bluetiger9/ScanMeBadge/README.md

# ScanMeBadge

KiCad - KiCad project

InkScape - Inkscape drawing

ScanMeBadge - Arduino example sketch

### Licence

Design files: CC-by-4.0

Example code: MIT
