bluetiger9/ScanMeBadge/KiCad/g3840.png

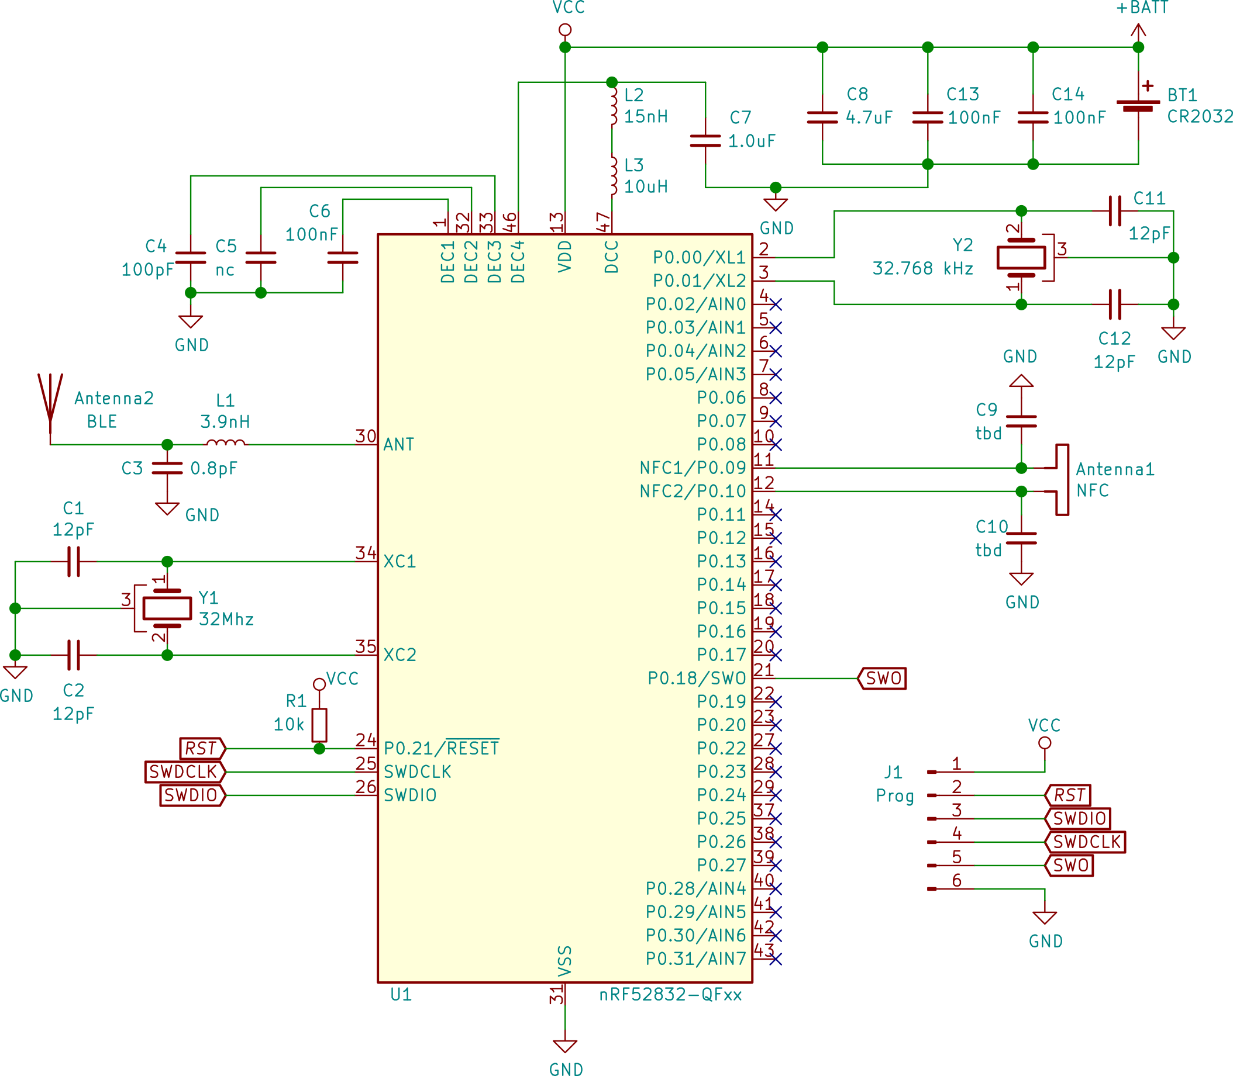
KiCad/g3840.png
