bluetiger9/ScanMeBadge/KiCad/BLE-NFC-Badge.kicad_pcb

## KiCad design KiCad/BLE-NFC-Badge.kicad_pcb (2019-03-12)

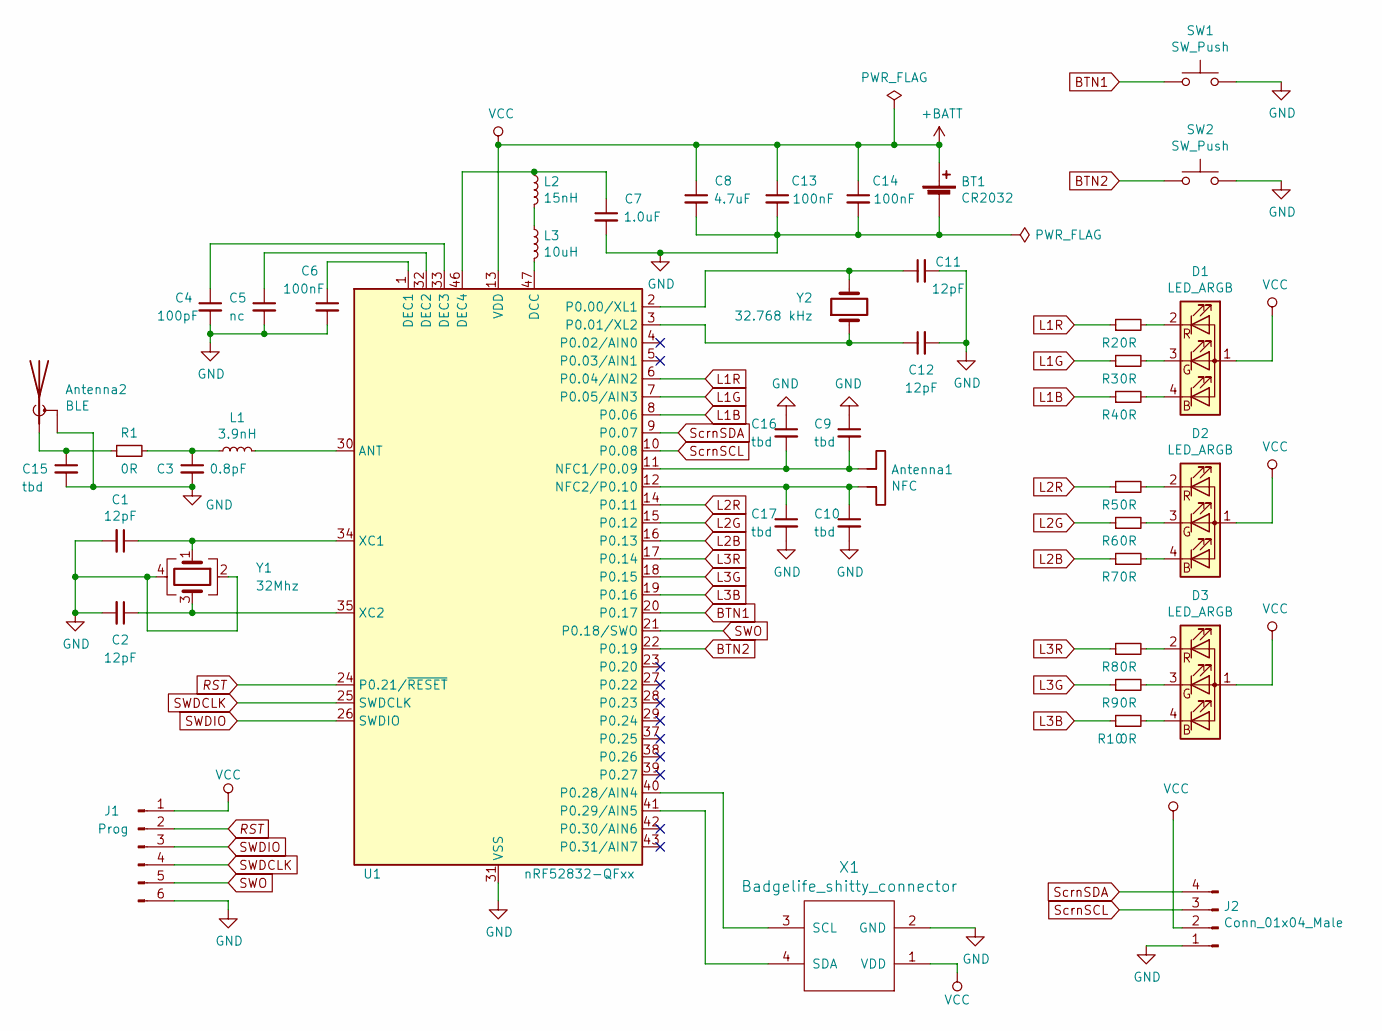
[picture p2: schematic BLE-NFC-Badge.sch]

Parts:
Antenna1: NFC
Antenna2: BLE; Texas_SWRA117D_2.4GHz_Right
BT1: CR2032; BatteryHolder_Keystone_1060_1x2032
C1, C2, C11, C12: 12pF; C_0805_2012Metric
C3: 0.8pF; C_0805_2012Metric
C4: 100pF; C_0805_2012Metric
C5: nc; C_0805_2012Metric
C6, C13, C14: 100nF; C_0805_2012Metric
C7: 1.0uF; C_0805_2012Metric
C8: 4.7uF; C_0805_2012Metric
C9, C10, C15, C16, C17: tbd; C_0805_2012Metric
D1, D2, D3: LED_ARGB; LED_Kingbright_AAA3528ESGCT
J1: Prog; PinHeader_1x06_P2.00mm_Pad
J2: Conn_01x04_Male; PinHeader_1x04_P2.54mm_Pad
L1: 3.9nH; L_0805_2012Metric
L2: 15nH; L_0805_2012Metric
L3: 10uH; L_0805_2012Metric
R1, R2, R3, R4, R5, R6, R7, R8, R9, R10: 0R; R_0805_2012Metric
SW1, SW2: SW_Push; SW_SPST_TL3342
U1: nRF52832-QFxx; QFN-48-1EP_6x6mm_P0.4mm_EP4.66x4.66mm
X1: Badgelife_shitty_connector; Badgelife-Shitty-2x2
Y1: 32Mhz; Crystal_SMD_2016-4Pin_2.0x1.6mm
Y2: 32.768 kHz; Crystal_SMD_3215-2Pin_3.2x1.5mm

Connections:
+BATT: BT1.1 (+), C8.1, C13.1, C14.1, D1.1 (A), D2.1 (A), D3.1 (A), J1.1, J2.2, U1.13 (VDD), U1.36 (VDD), U1.48 (VDD), X1.1 (VDD)
BTN1: SW1.1, U1.20 (P0.17)
BTN2: SW2.1, U1.22 (P0.19)
GND: Antenna2.2 (Shield), BT1.2 (-), C1.2, C2.2, C3.2, C4.2, C5.2, C6.2, C7.2, C8.2, C9.1, C10.2, C11.2, C12.2, C13.2, C14.2, C15.2, C16.1, C17.2, J1.6, J2.1, SW1.2, SW2.2, U1.31 (VSS), U1.45 (VSS), U1.49 (VSS), X1.2 (GND), Y1.2, Y1.4
L1B: R4.1, U1.8 (P0.06)
L1G: R3.1, U1.7 (P0.05/AIN3)
L1R: R2.1, U1.6 (P0.04/AIN2)
L2B: R7.1, U1.16 (P0.13)
L2G: R6.1, U1.15 (P0.12)
L2R: R5.1, U1.14 (P0.11)
L3B: R10.1, U1.19 (P0.16)
L3G: R9.1, U1.18 (P0.15)
L3R: R8.1, U1.17 (P0.14)
unnamed: Antenna1.1, C9.2, C16.2, U1.11 (NFC1/P0.09)
unnamed: Antenna1.2, C10.1, C17.1, U1.12 (NFC2/P0.10)
unnamed: Antenna2.1 (A), C15.1, R1.1
unnamed: C1.1, U1.34 (XC1), Y1.1
unnamed: C2.1, U1.35 (XC2), Y1.3
unnamed: C3.1, L1.1, R1.2
unnamed: C4.1, U1.33 (DEC3)
unnamed: C5.1, U1.32 (DEC2)
unnamed: C6.1, U1.1 (DEC1)
unnamed: C7.1, L2.1, U1.46 (DEC4)
unnamed: C11.1, U1.2 (P0.00/XL1), Y2.2
unnamed: C12.1, U1.3 (P0.01/XL2), Y2.1
unnamed: D1.2 (RK), R2.2
unnamed: D1.3 (GK), R3.2
unnamed: D1.4 (BK), R4.2
unnamed: D2.2 (RK), R5.2
unnamed: D2.3 (GK), R6.2
unnamed: D2.4 (BK), R7.2
unnamed: D3.2 (RK), R8.2
unnamed: D3.3 (GK), R9.2
unnamed: D3.4 (BK), R10.2
unnamed: L1.2, U1.30 (ANT)
unnamed: L2.2, L3.1
unnamed: L3.2, U1.47 (DCC)
unnamed: U1.40 (P0.28/AIN4), X1.3 (SCL)
unnamed: U1.41 (P0.29/AIN5), X1.4 (SDA)
RST: J1.2, U1.24 (P0.21/~RESET)
SWDCLK: J1.4, U1.25 (SWDCLK)
SWDIO: J1.3, U1.26 (SWDIO)
SWO: J1.5, U1.21 (P0.18/SWO)
ScrnSCL: J2.3, U1.10 (P0.08)
ScrnSDA: J2.4, U1.9 (P0.07)

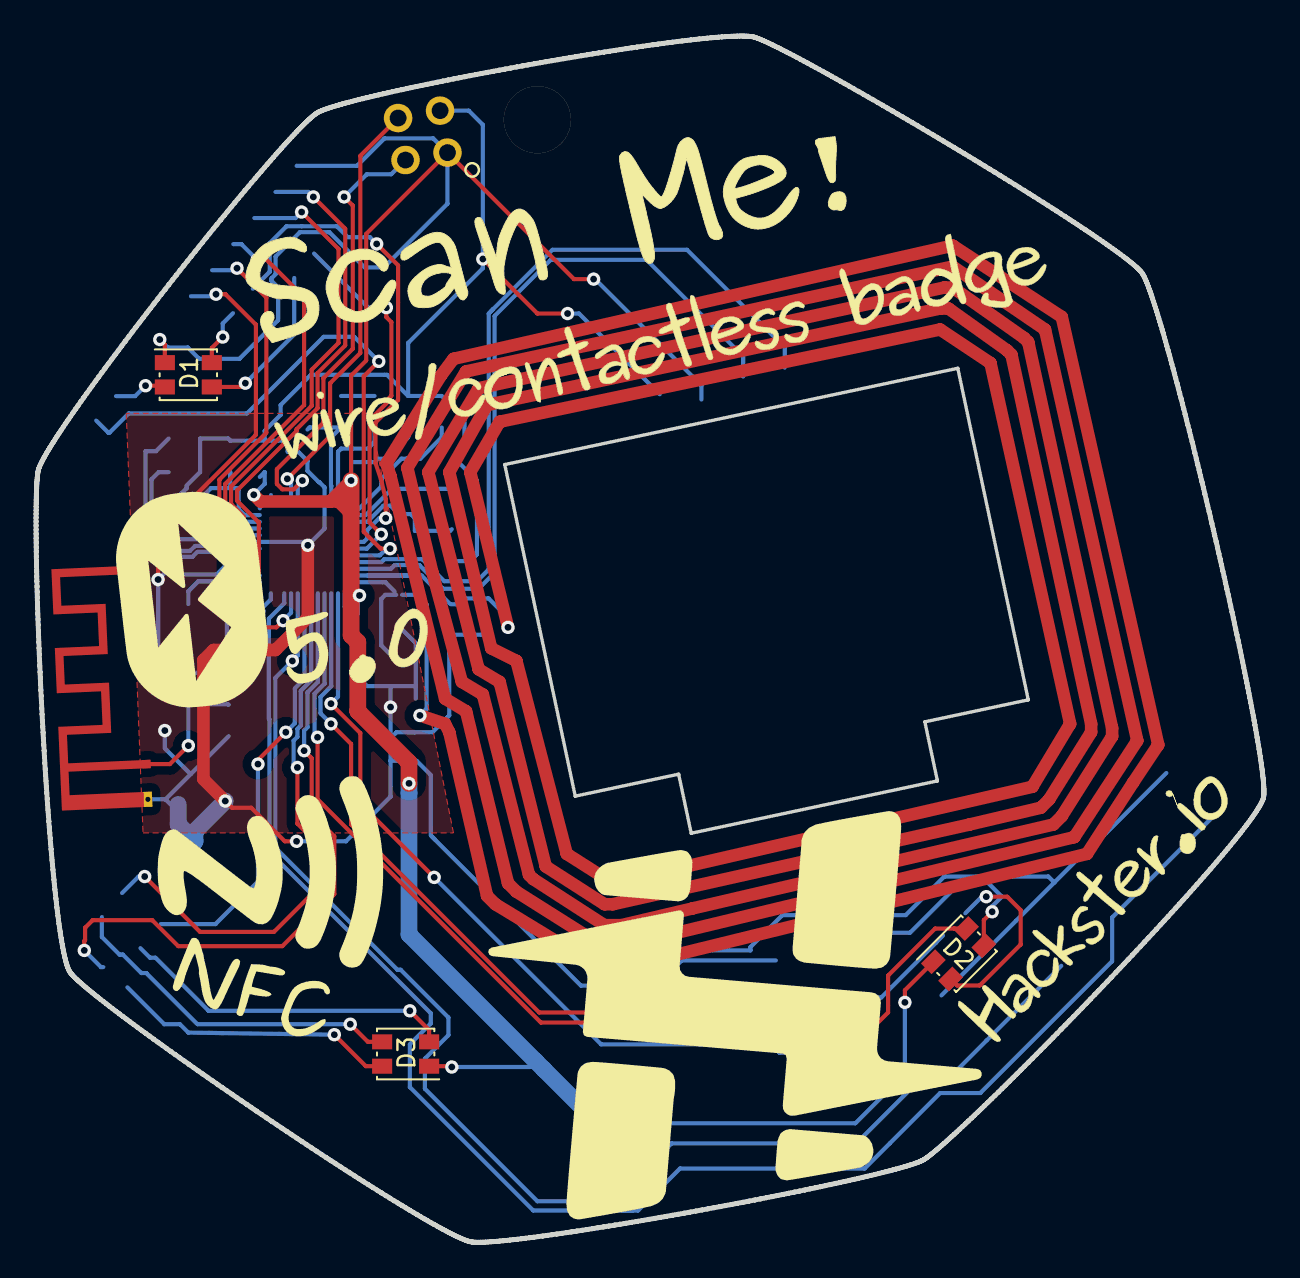
[picture p3: board BLE-NFC-Badge.kicad_pcb from above]

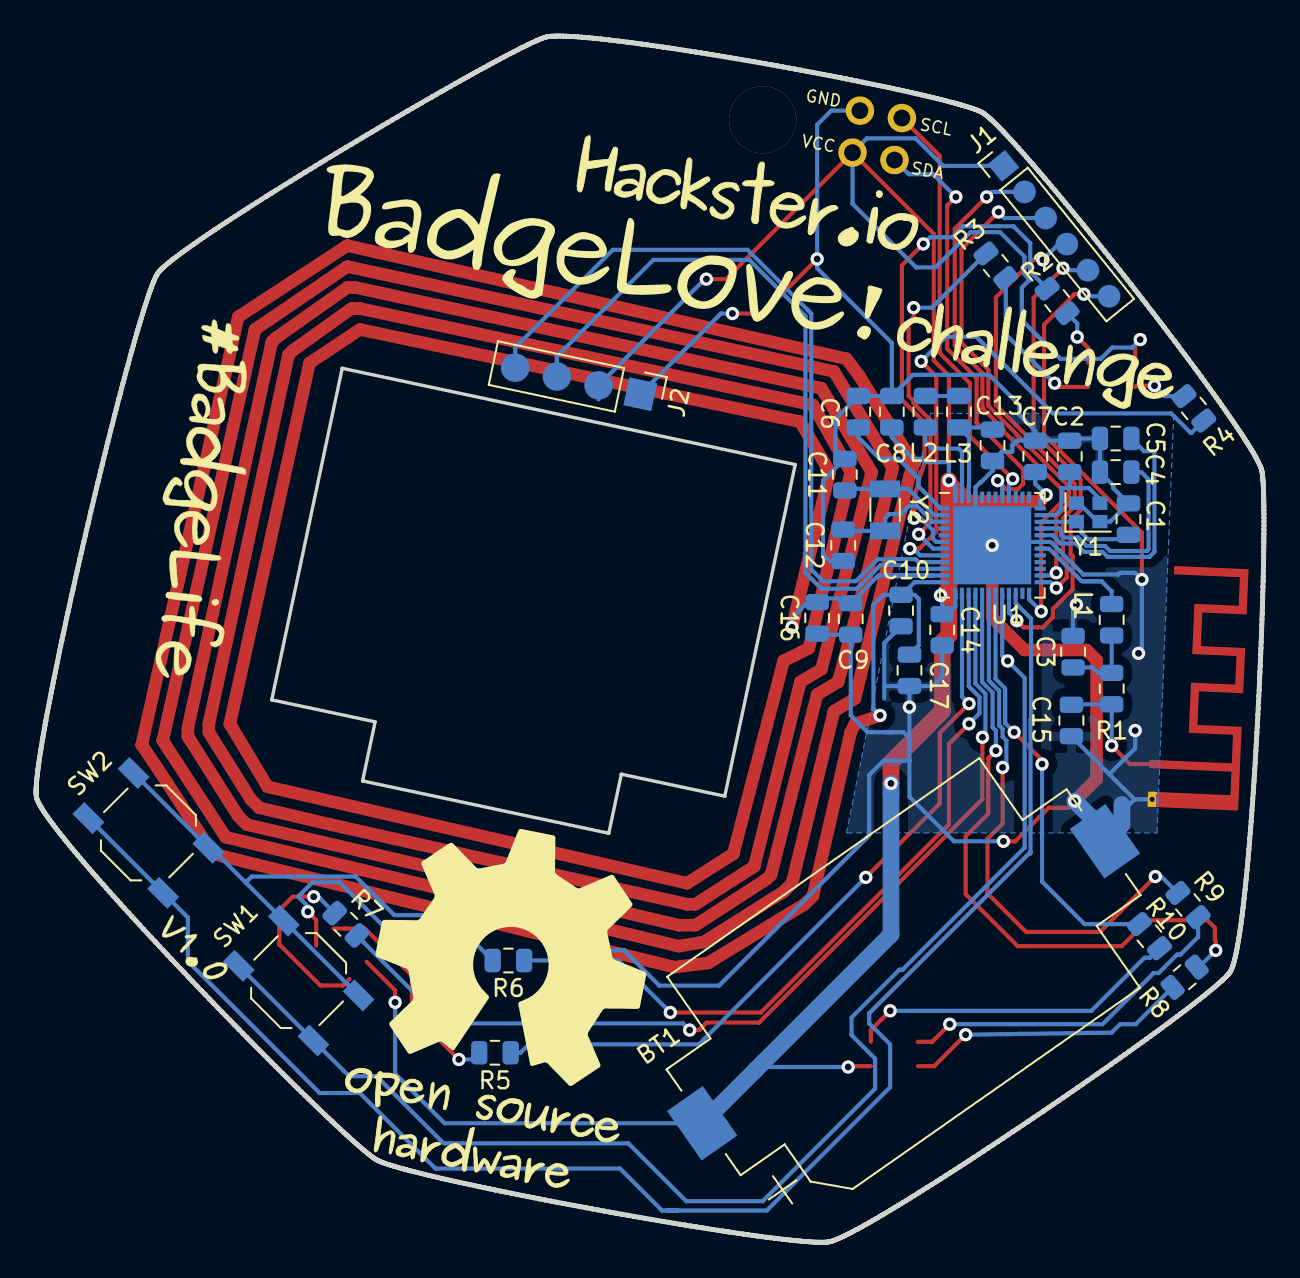
[picture p4: board BLE-NFC-Badge.kicad_pcb from below]

Board: 2 copper layers, 73.2 x 71.9 mm, 45 parts (38 on the bottom side), 45 nets.

Other parts of the board:
svg2mod: G***; scan-me-badge-2
svg2mod#2: G***; scan-me-badge
